publiclab/spectrometer3/parts/box/box_design/spec-box-top-alltab-yagiz.jpg

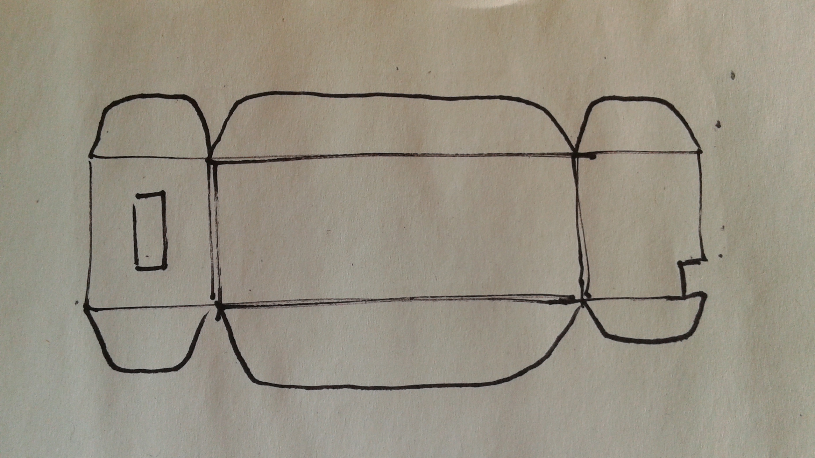
parts/box/box_design/spec-box-top-alltab-yagiz.jpg
