publiclab/spectrometer3/photos/IMG_3429.JPG

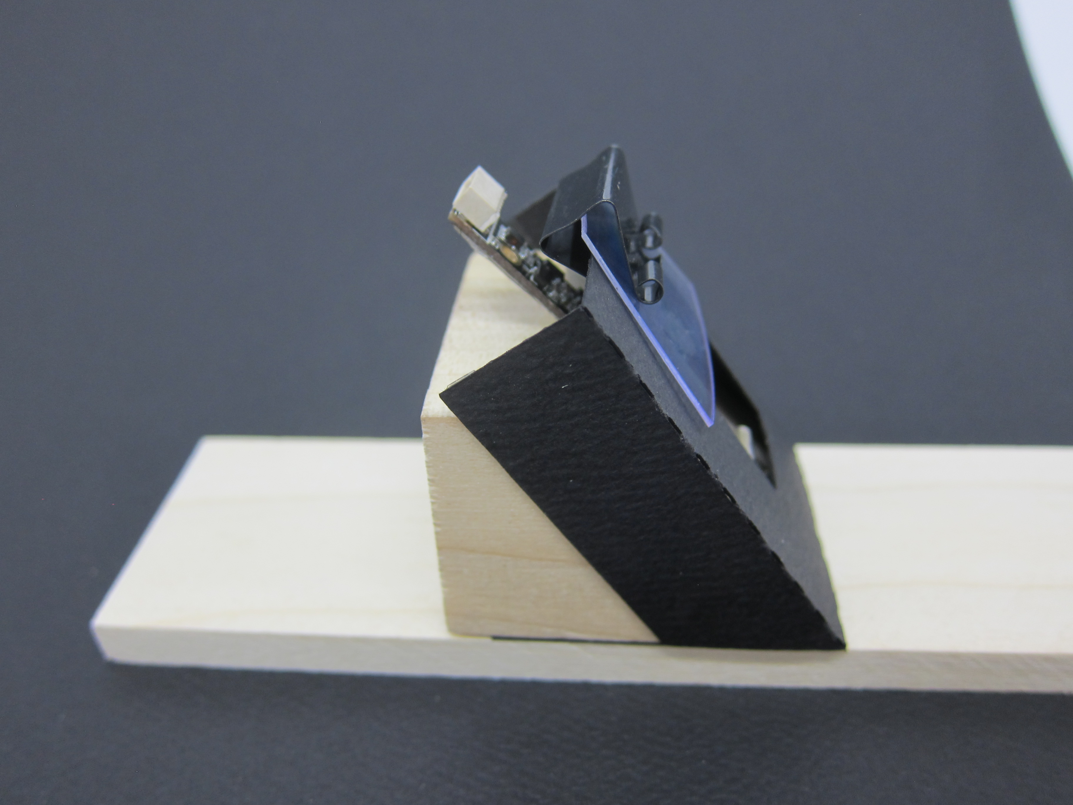
photos/IMG_3429.JPG
