publiclab/spectrometer3/photos/IMG_3420.JPG

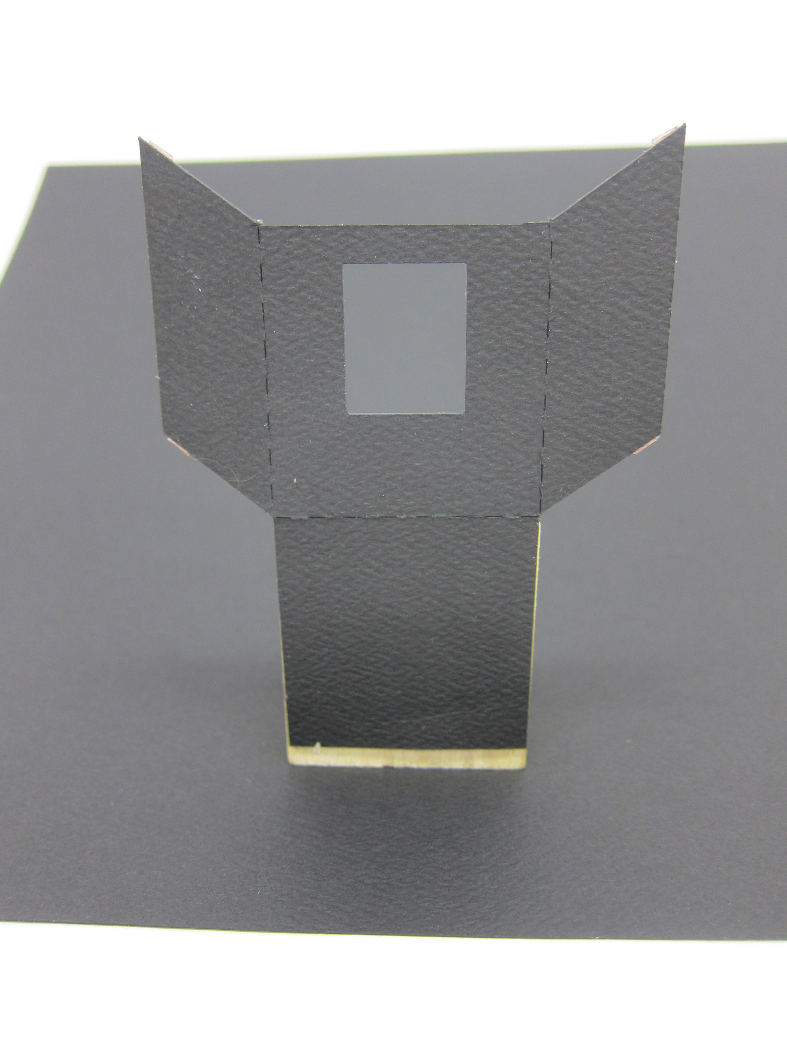
photos/IMG_3420.JPG
