publiclab/spectrometer3/photos/IMG_3421.JPG

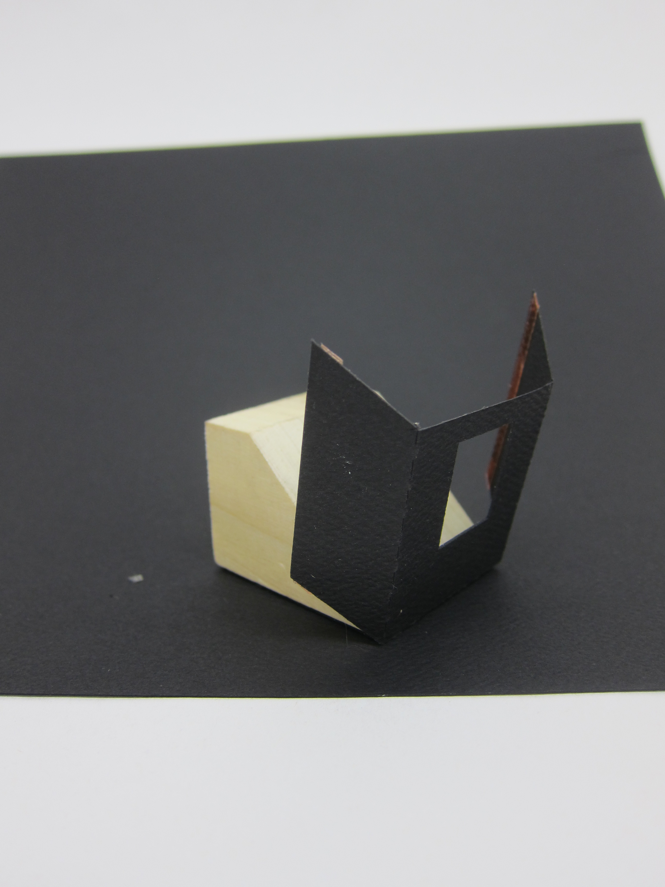
photos/IMG_3421.JPG
