publiclab/spectrometer3/photos/IMG_3422.JPG

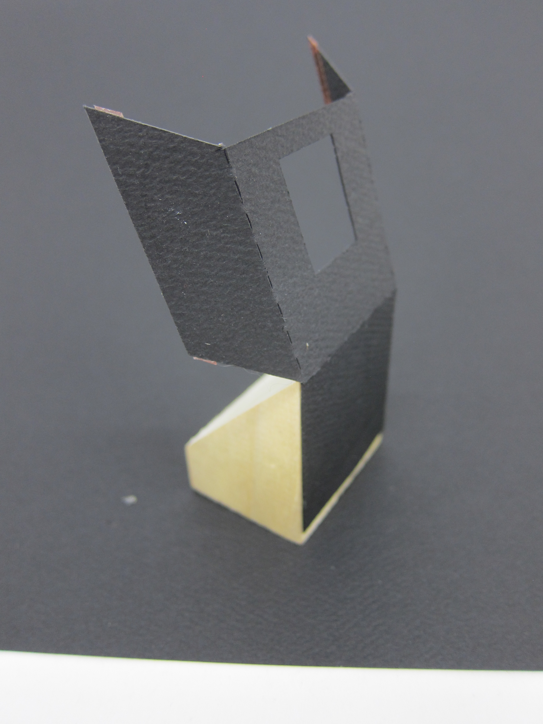
photos/IMG_3422.JPG
