publiclab/spectrometer3/photos/IMG_3423.JPG

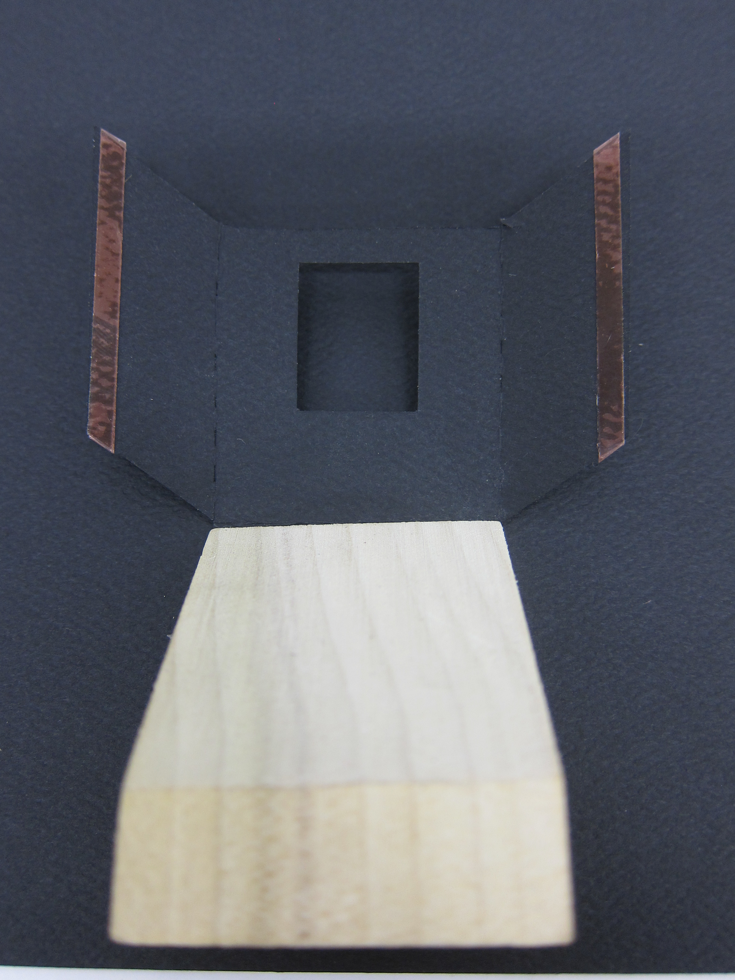
photos/IMG_3423.JPG
