publiclab/spectrometer3/photos/IMG_3424.JPG

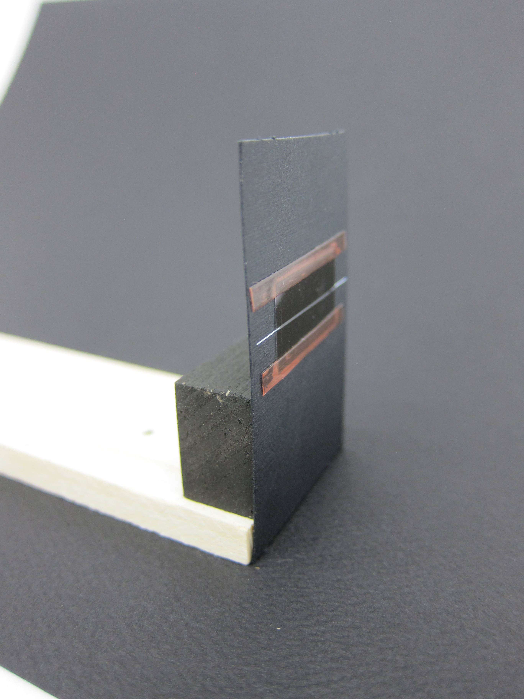
photos/IMG_3424.JPG
