publiclab/spectrometer3/photos/IMG_3426.JPG

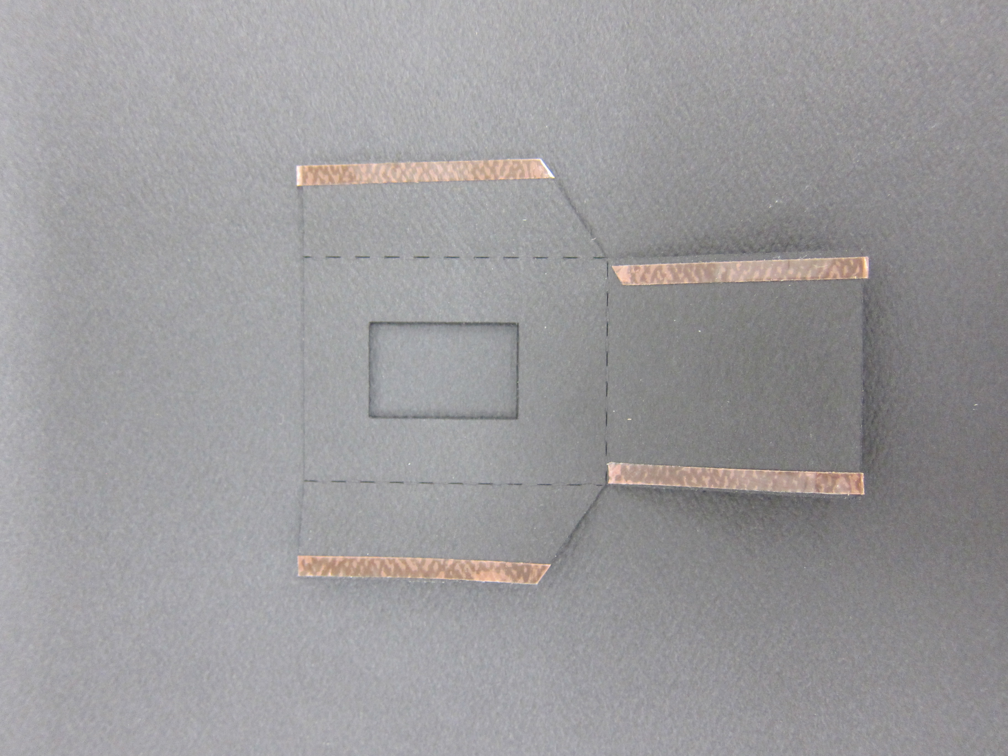
photos/IMG_3426.JPG
