publiclab/spectrometer3/photos/IMG_3427.JPG

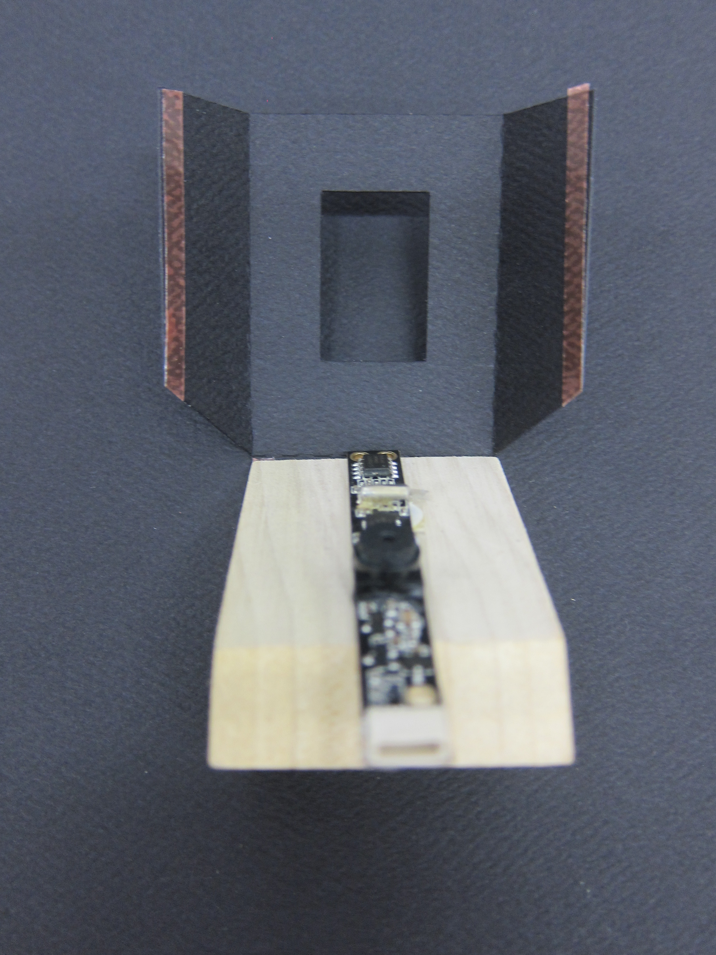
photos/IMG_3427.JPG
