publiclab/spectrometer3/photos/IMG_3428.JPG

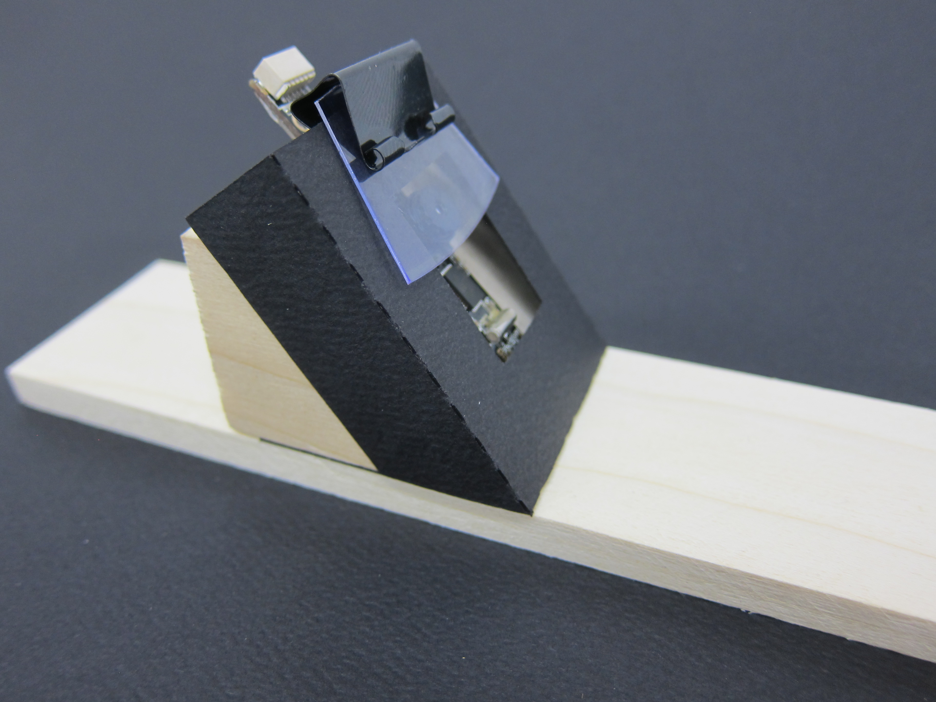
photos/IMG_3428.JPG
