publiclab/spectrometer3/photos/IMG_3430.JPG

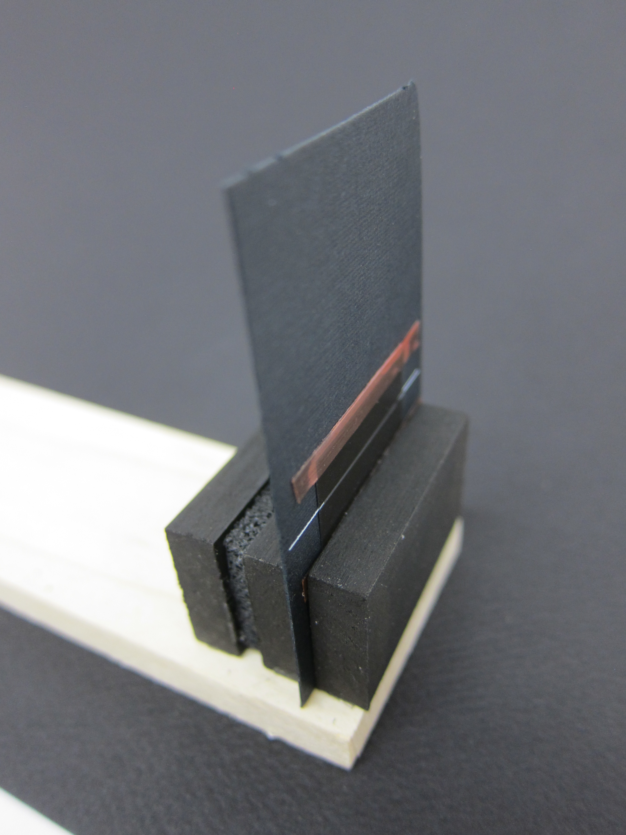
photos/IMG_3430.JPG
