publiclab/spectrometer3/photos/IMG_3431.JPG

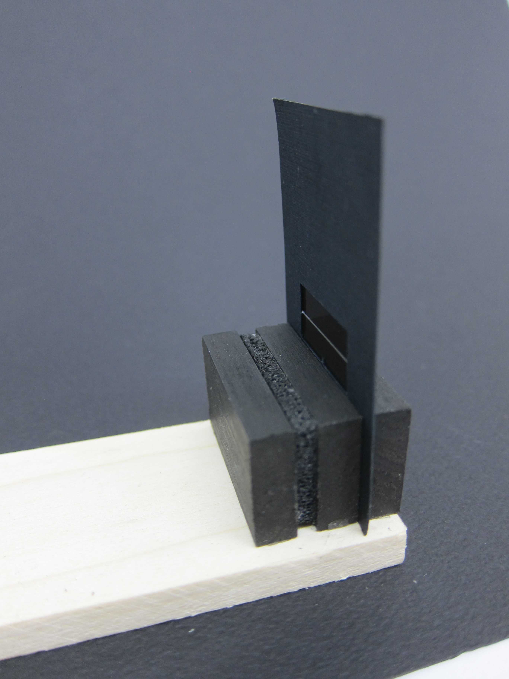
photos/IMG_3431.JPG
