publiclab/spectrometer3/photos/IMG_3432.JPG

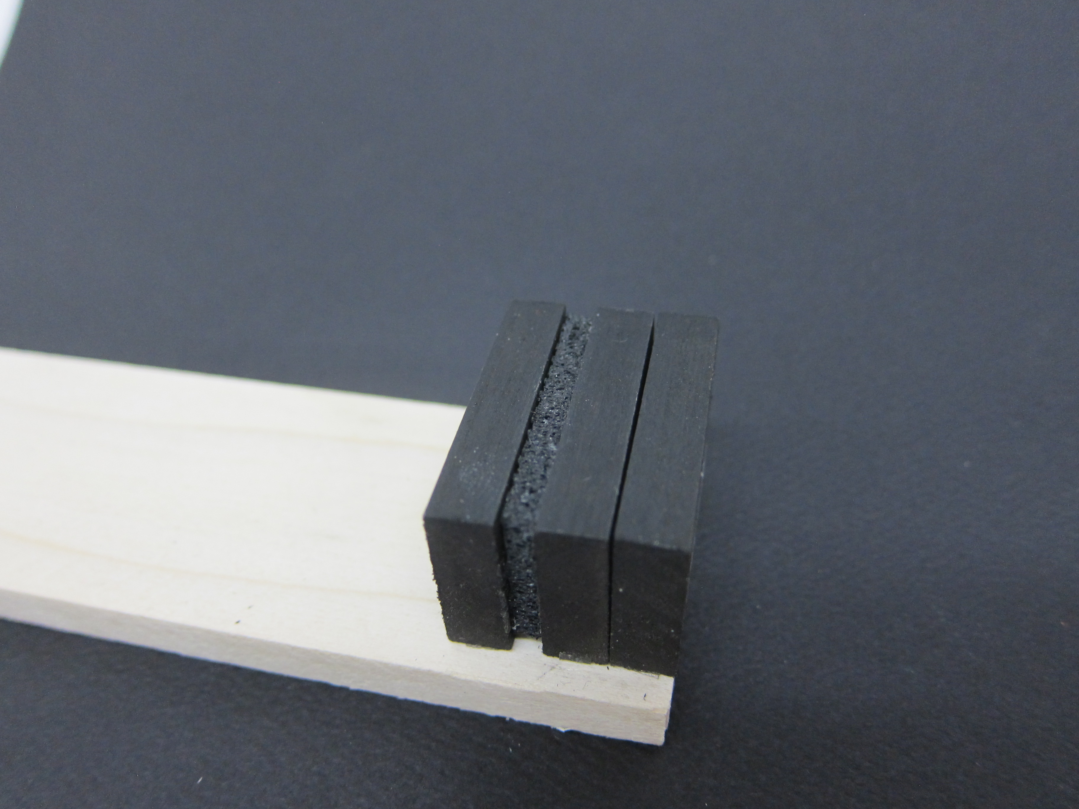
photos/IMG_3432.JPG
