publiclab/spectrometer3/photos/IMG_3433.JPG

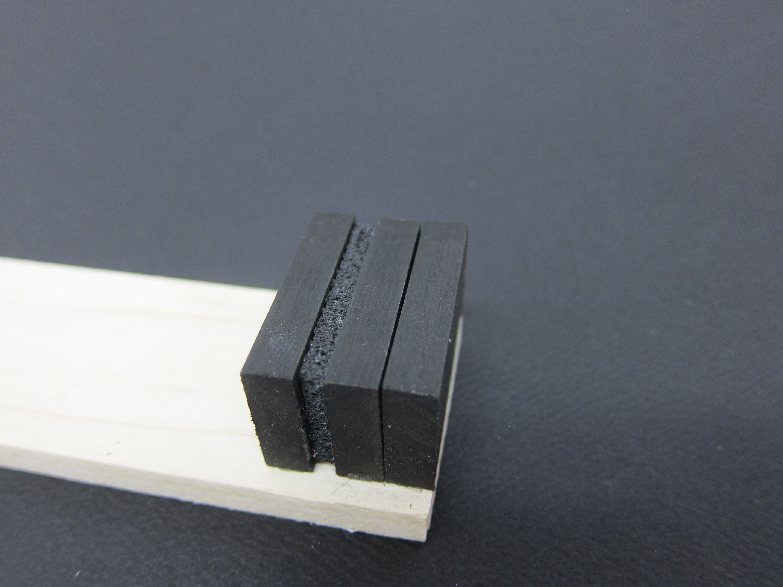
photos/IMG_3433.JPG
