publiclab/spectrometer3/photos/IMG_3434.JPG

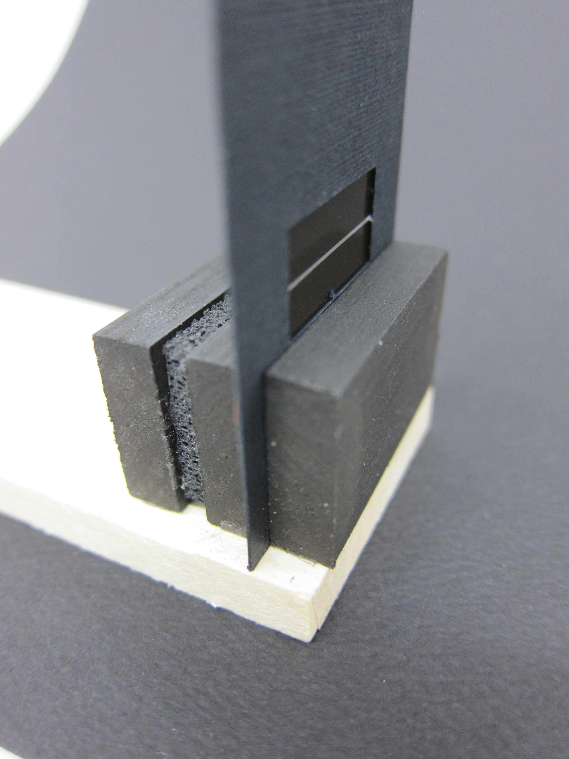
photos/IMG_3434.JPG
