publiclab/spectrometer3/photos/IMG_3435.JPG

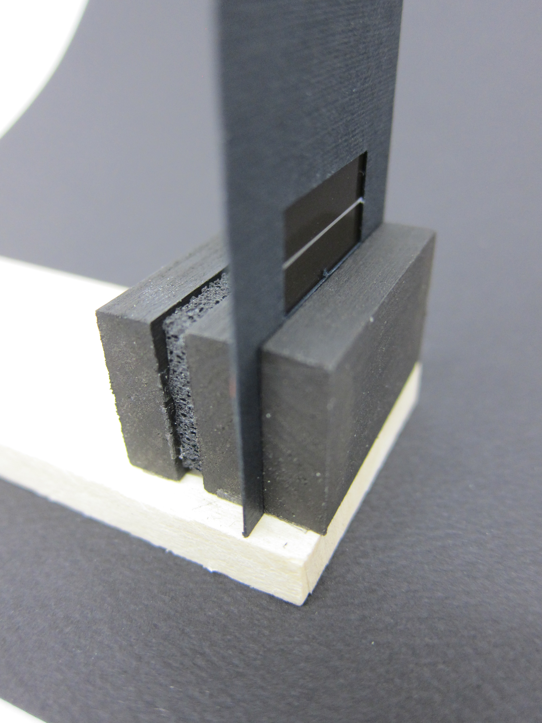
photos/IMG_3435.JPG
