publiclab/spectrometer3/photos/IMG_3436.JPG

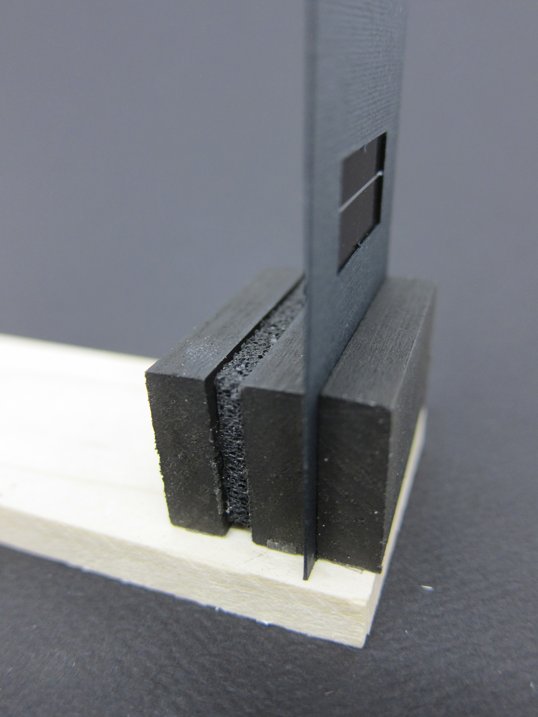
photos/IMG_3436.JPG
