publiclab/spectrometer3/photos/IMG_3437.JPG

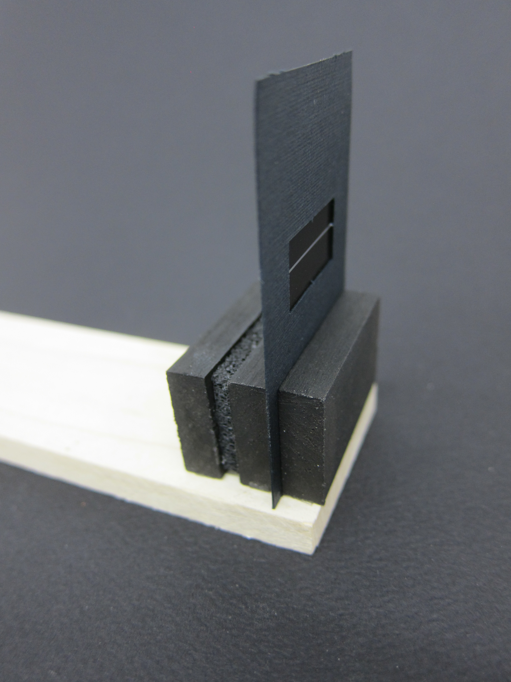
photos/IMG_3437.JPG
