publiclab/spectrometer3/photos/IMG_3438.JPG

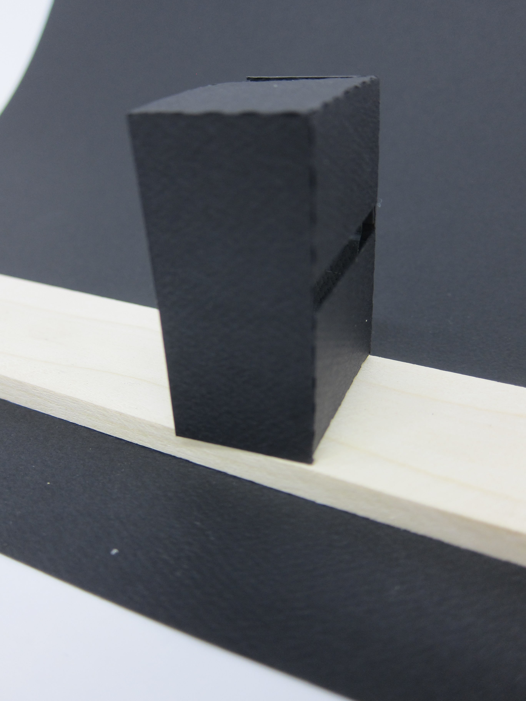
photos/IMG_3438.JPG
