publiclab/spectrometer3/photos/IMG_3439.JPG

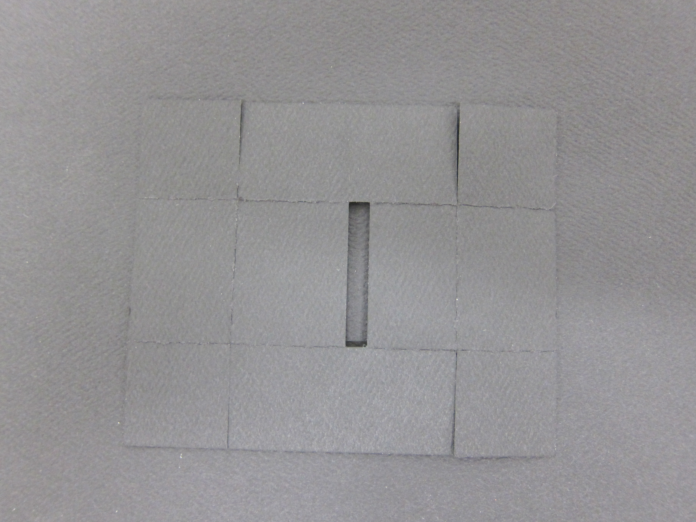
photos/IMG_3439.JPG
