publiclab/spectrometer3/parts/electronic_parts/camera_datasheet/camera-side-view.BMP

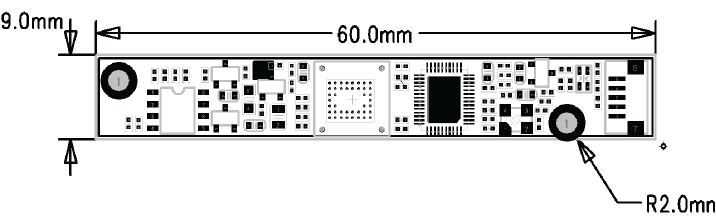
parts/electronic_parts/camera_datasheet/camera-side-view.BMP
