publiclab/spectrometer3/parts/electronic_parts/camera_datasheet/camera-top-view.BMP

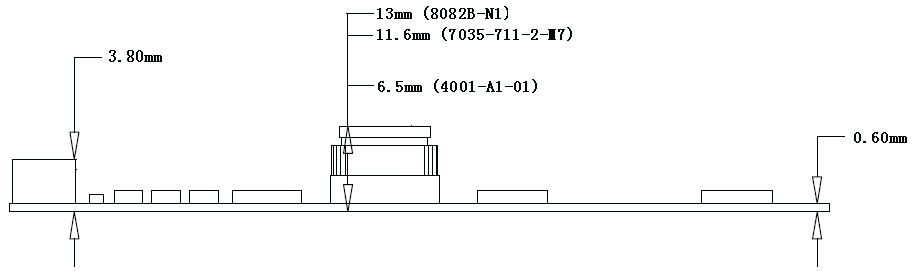
parts/electronic_parts/camera_datasheet/camera-top-view.BMP
