publiclab/spectrometer3/parts/paper-parts/baffle.bmp

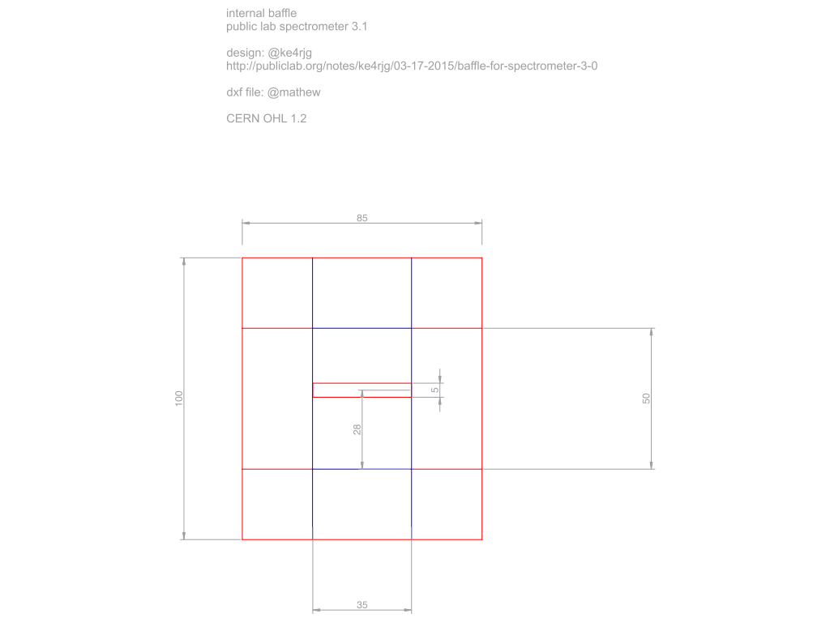
parts/paper-parts/baffle.bmp
