publiclab/spectrometer3/parts/paper-parts/grating-holder4.bmp

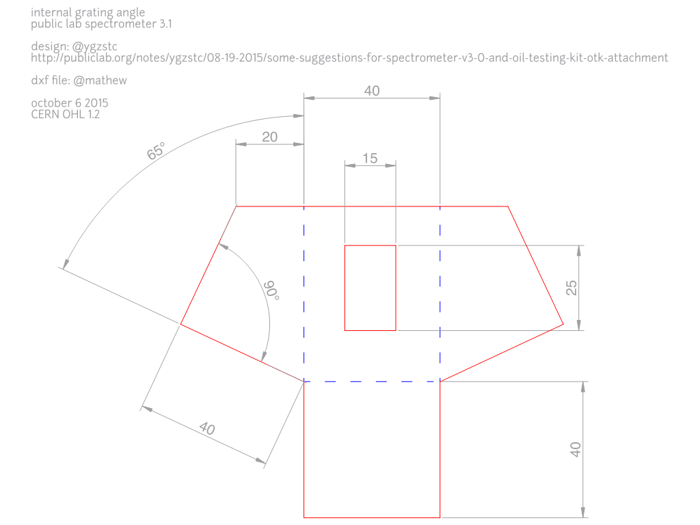
parts/paper-parts/grating-holder4.bmp
