publiclab/spectrometer3/parts/wood_parts/bench.bmp

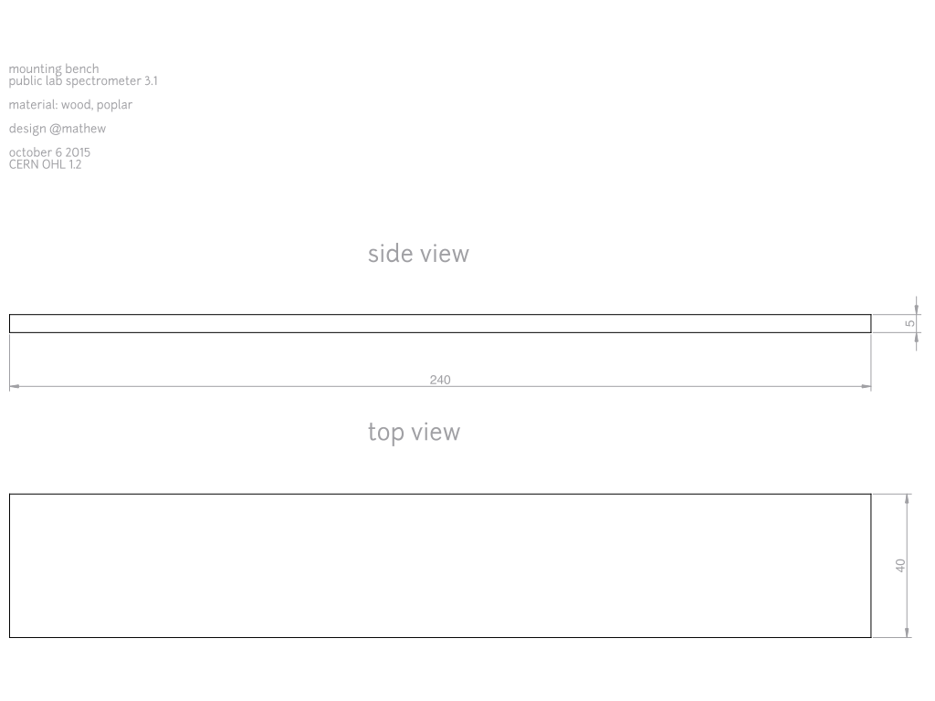
parts/wood_parts/bench.bmp
