publiclab/spectrometer3/parts/wood_parts/big-block.bmp

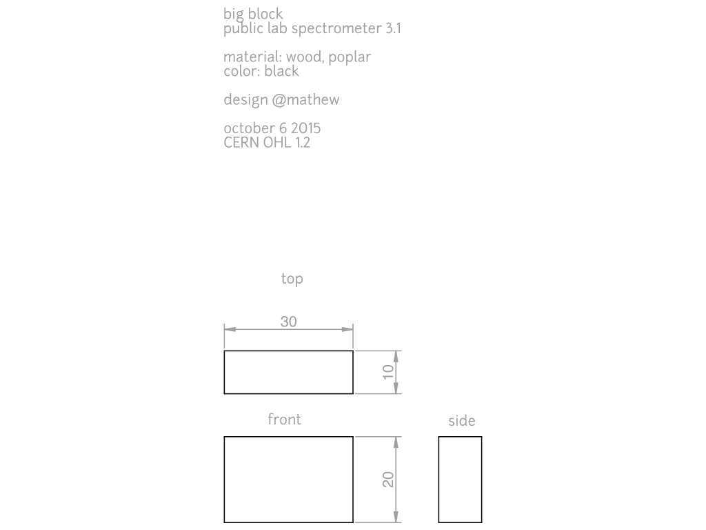
parts/wood_parts/big-block.bmp
