publiclab/spectrometer3/parts/wood_parts/camera-block.bmp

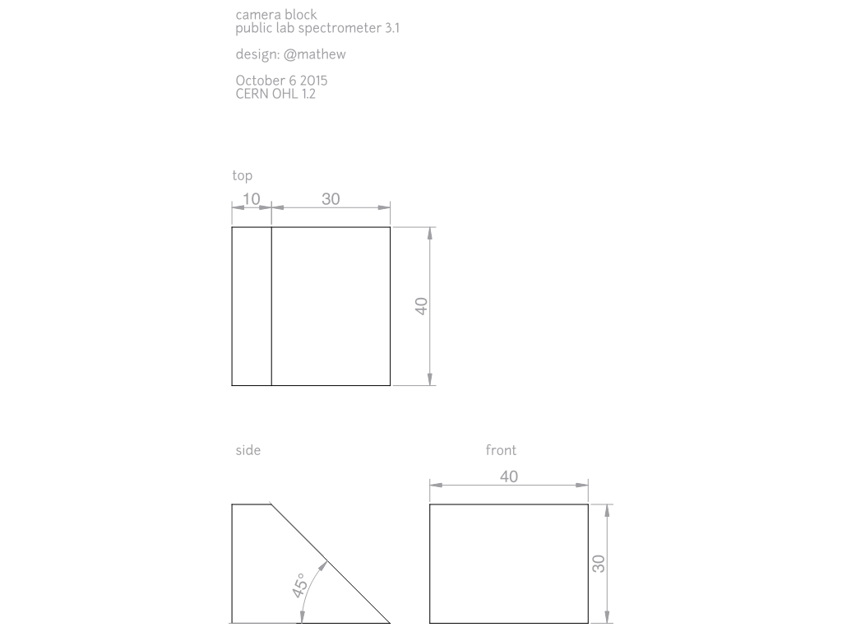
parts/wood_parts/camera-block.bmp
