publiclab/spectrometer3/layout1-stoft.dxf

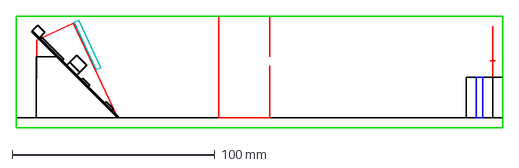
[picture p28: CAD file, 2015-10-08]
layout1-stoft.dxf
240.0 x 55.0 mm
