publiclab/spectrometer3/parts/electronic_parts/camera.dxf

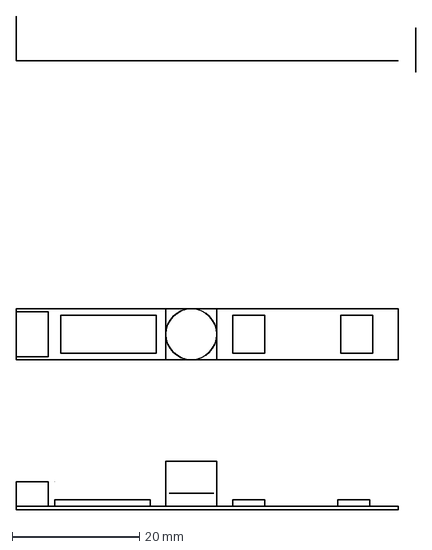
[picture p29: CAD file, 2015-10-08]
parts/electronic_parts/camera.dxf
62.7 x 77.6 mm
