publiclab/spectrometer3/parts/paper-parts/baffle.dxf

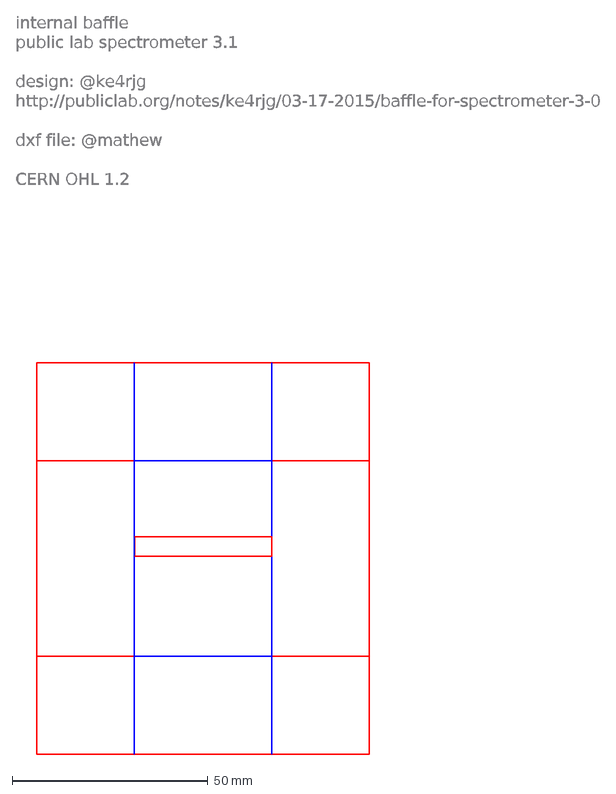
[picture p30: CAD file, 2015-10-08]
parts/paper-parts/baffle.dxf
internal baffle public lab spectrometer 3.1 design: @ke4rjg http://publiclab.org/notes/ke4rjg/03-17-2015/baffle-for-spectrometer-3-0 dxf file: @mathew CERN OHL
