publiclab/spectrometer3/layout3-mathew1.dxf

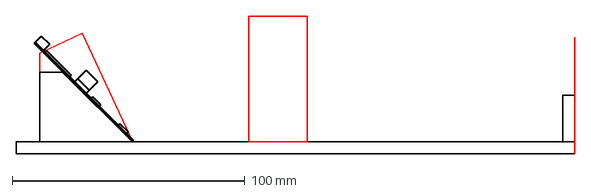
[picture p32: CAD file, 2015-10-08]
layout3-mathew1.dxf
240.0 x 59.0 mm
