publiclab/spectrometer3/parts/paper-parts/grating-holder4.dxf

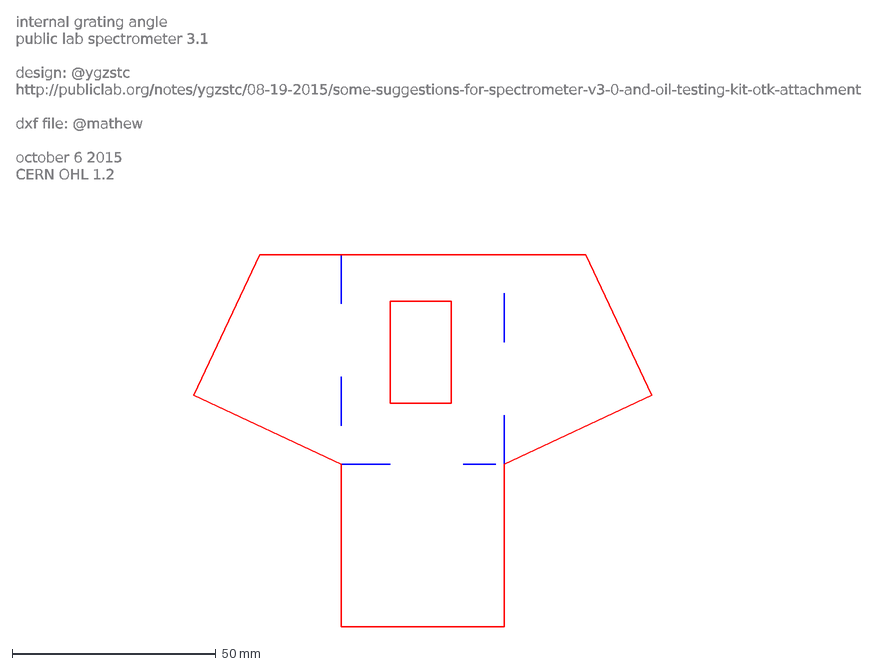
[picture p33: CAD file, 2015-10-08]
parts/paper-parts/grating-holder4.dxf
internal grating angle public lab spectrometer 3.1 design: @ygzstc http://publiclab.org/notes/ygzstc/08-19-2015/some-suggestions-for-spectrometer-v3-0-and-oil-t
