publiclab/spectrometer3/parts/wood_parts/camera-block.dxf

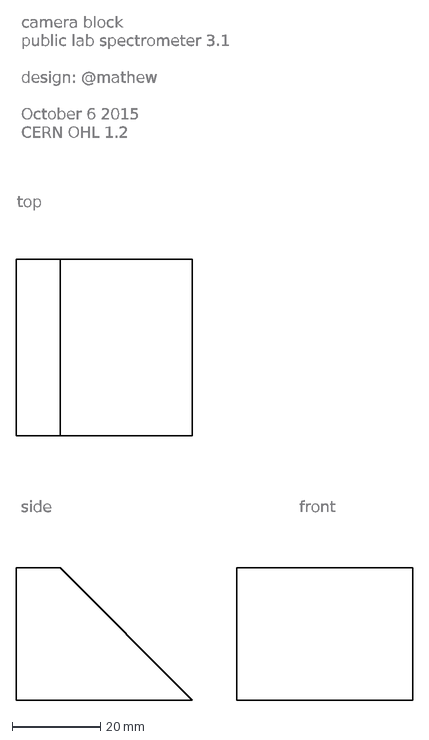
[picture p34: CAD file, 2015-10-08]
parts/wood_parts/camera-block.dxf
front
side
top
camera block public lab spectrometer 3.1 design: @mathew October 6 2015 CERN OHL 1.2
