publiclab/spectrometer3/layout2-mathew.dxf

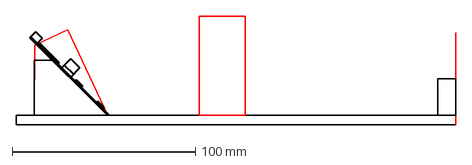
[picture p35: CAD file, 2015-10-08]
layout2-mathew.dxf
240.0 x 59.0 mm
