publiclab/spectrometer3/parts/wood_parts/block.dxf

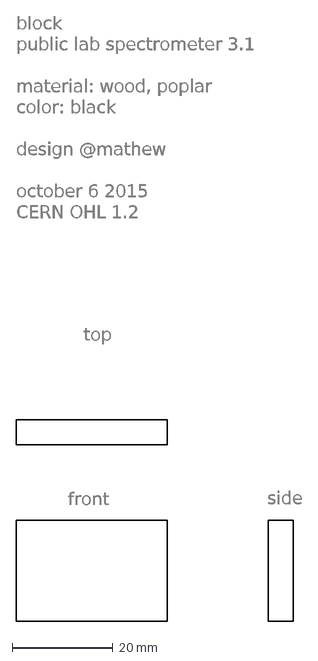
[picture p37: CAD file, 2015-10-08]
parts/wood_parts/block.dxf
block public lab spectrometer 3.1 material: wood, poplar color: black design @mathew october 6 2015 CERN OHL 1.2
top
front
side
