publiclab/spectrometer3/parts/wood_parts/bench.dxf

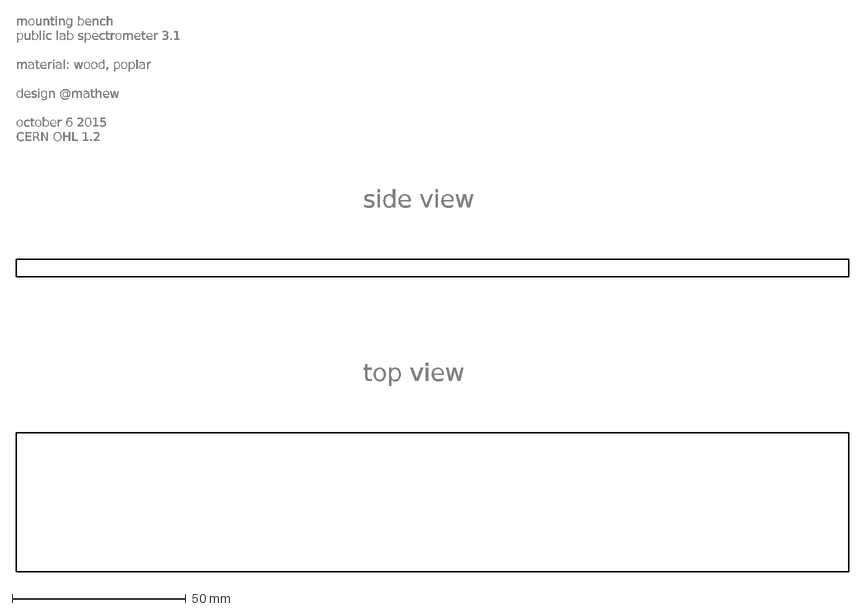
[picture p38: CAD file, 2015-10-08]
parts/wood_parts/bench.dxf
mounting bench public lab spectrometer 3.1 material: wood, poplar design @mathew october 6 2015 CERN OHL 1.2
side view
top view
