publiclab/spectrometer3/old/grating-holder.dxf

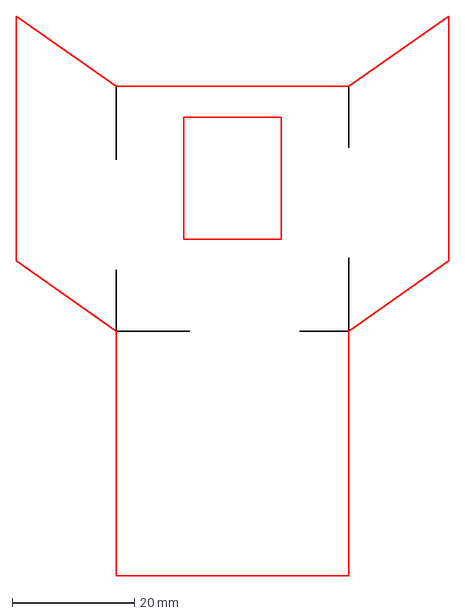
[picture p39: CAD file, 2015-10-08, an earlier design]
old/grating-holder.dxf
70.8 x 91.5 mm
