publiclab/spectrometer3/old/grating-holder2.dxf

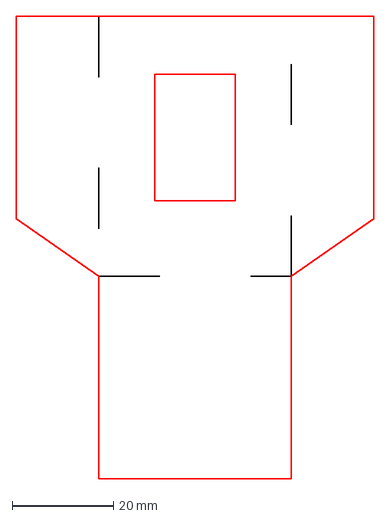
[picture p40: CAD file, 2015-10-08, an earlier design]
old/grating-holder2.dxf
70.8 x 91.5 mm
