publiclab/spectrometer3/(threads)

Thread 6 (2014-08-07):

label user contributions in the printed parts

mathewlippincott, 2014-08-07:
put a note that references the research note that led to a design feature, so users can learn more, such as: /n/12345
print these directly onto the kit.

mathewlippincott, 2015-01-20:
Done.
http://publiclab.org/notes/mathew/01-17-2015/shortlinks-putting-contributors-directly-on-a-kit

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

Closed 2015-01-20.

Thread 13 (2015-03-19):

shorten spec very slightly to fit in box

jywarren, 2015-03-19:
I had some clearance issues with the box tabs; even a 0.5cm shortening would help!

http://publiclab.org/notes/stevie/01-28-2015/working-with-the-spec-3-0#c11319

tonypubliclab, 2015-11-03:
if we made the side walls slightly lower, this piece would fit in the box at the current length. Right now it is slightly too long in both directions. If the walls were shorter, the piece would fit flat in the box. If the piece fit flat in the box, the issue with the length, where the box flaps interfere with the housing, becomes a non-issue. If this piece were sitting flat on the bottom, the box flaps would actually pin the piece down making it more secure for shipping.

I say if we can shorten the walls by a tiny amount, let's do that and leave the length as-is. This was feedback/idea from mathew, if any questions on how to implement...

mathewlippincott, 2015-11-03:
Here are the dimensional changes that would fit with the wood pieces I uploaded in the [community additions](https://github.com/publiclab/spectrometer3/tree/community-additions) branch
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

mathewlippincott, 2015-11-03:
here's the lid annotations:
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

jywarren, 2015-11-05:
Separating height from length size change - moving height (and @mathewlippincott's comments) to #31

Thread 18 (2015-07-27):

Add cover flap with tabs to OTK attachment

jywarren, 2015-07-27:
http://publiclab.org/notes/mathew/04-07-2015/assembling-the-oil-testing-kit-cuvette-frame

to reduce ambient light and laser scattering

jywarren, 2015-11-05:
Complete

Closed 2015-11-05.

Thread 20 (2015-08-03):

Longer/taller wood block

jywarren, 2015-08-03:
> I just assembled my Spectrometry kit 3.0. When I plugged in the USB, my computer did not recognize the device (webcam). I thought maybe I had not pushed the plug onto the camera enough so I pushed a little more, but alas it broke off.
> One good thing can come out of this and that is to revise the shape of the block. It needs to go higher to support the connection end of the camera so others don't do the same thing. There's plenty of room between the top of the box and the end of the webcam.

jywarren, 2015-08-03:
via Tim C

Thread 24 (2015-08-17):

Separation of internals from enclosure for rigidity

jywarren, 2015-08-17:
See @Stoft1's thoughts here: http://publiclab.org/notes/stoft/03-02-2015/plab-3-spectrometer-upgrade-prototype

The main point of separation we need to consider seems to be the slit -- i.e. is there a way to make a swappable slit as in the current design, but separate it from the casing? This doesn't even have to affect the current die cut designs, as it could be mounted on the plank inside, just a few millimeters back from the existing rectangular opening, with a cowling to prevent ambient light.

Thread 26 (2015-09-01):

labelled print layer scale indicator

jywarren, 2015-09-01:
that is at least as long as the greatest dimension in one axis, for confirming correct scale when going to cut or print

Thread 31 (2015-11-05):

Shorten box height to make fit in shipping box flat

jywarren, 2015-11-05:
The kit currently has to be diagonal to fit in the shipping box. Shorten it slightly (measurements coming) so it ships flat on the bottom.

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

jywarren, 2015-11-05:
Copying in solution via @mathewlippincott from #13 --

> Here are the dimensional changes that would fit with the wood pieces I uploaded in the [community additions](https://github.com/publiclab/spectrometer3/tree/community-additions) branch

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

> here's the lid annotations:

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

jywarren, 2015-11-09:
Just a note that this change must not cause trouble with the webcam clearance -- see this photo:

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

jywarren, 2015-11-09:
I'd like to drop it by 1cm (which would get us 2cm better fit in the box) but I'm not sure the webcam will allow for that. Will test it.

Thread 32 (2015-11-05):

Include slit print production file in repo

jywarren, 2015-11-05:
https://www.dropbox.com/work/plots/design/11-10-14-foldup-spectrometer-redesign

Thread 33 (2016-11-07):

Remove duplicated cut path

numeroteca, 2016-11-07:
I think there is a duplicated cut path in https://github.com/publiclab/spectrometer3/blob/master/spec-box-bottom.svg
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

jywarren, 2016-11-17:
Ah, could you submit a fixed file as a pull request? Thanks, Pablo!
