publiclab/spectrometer3/parts/paper-parts/baffle.pdf

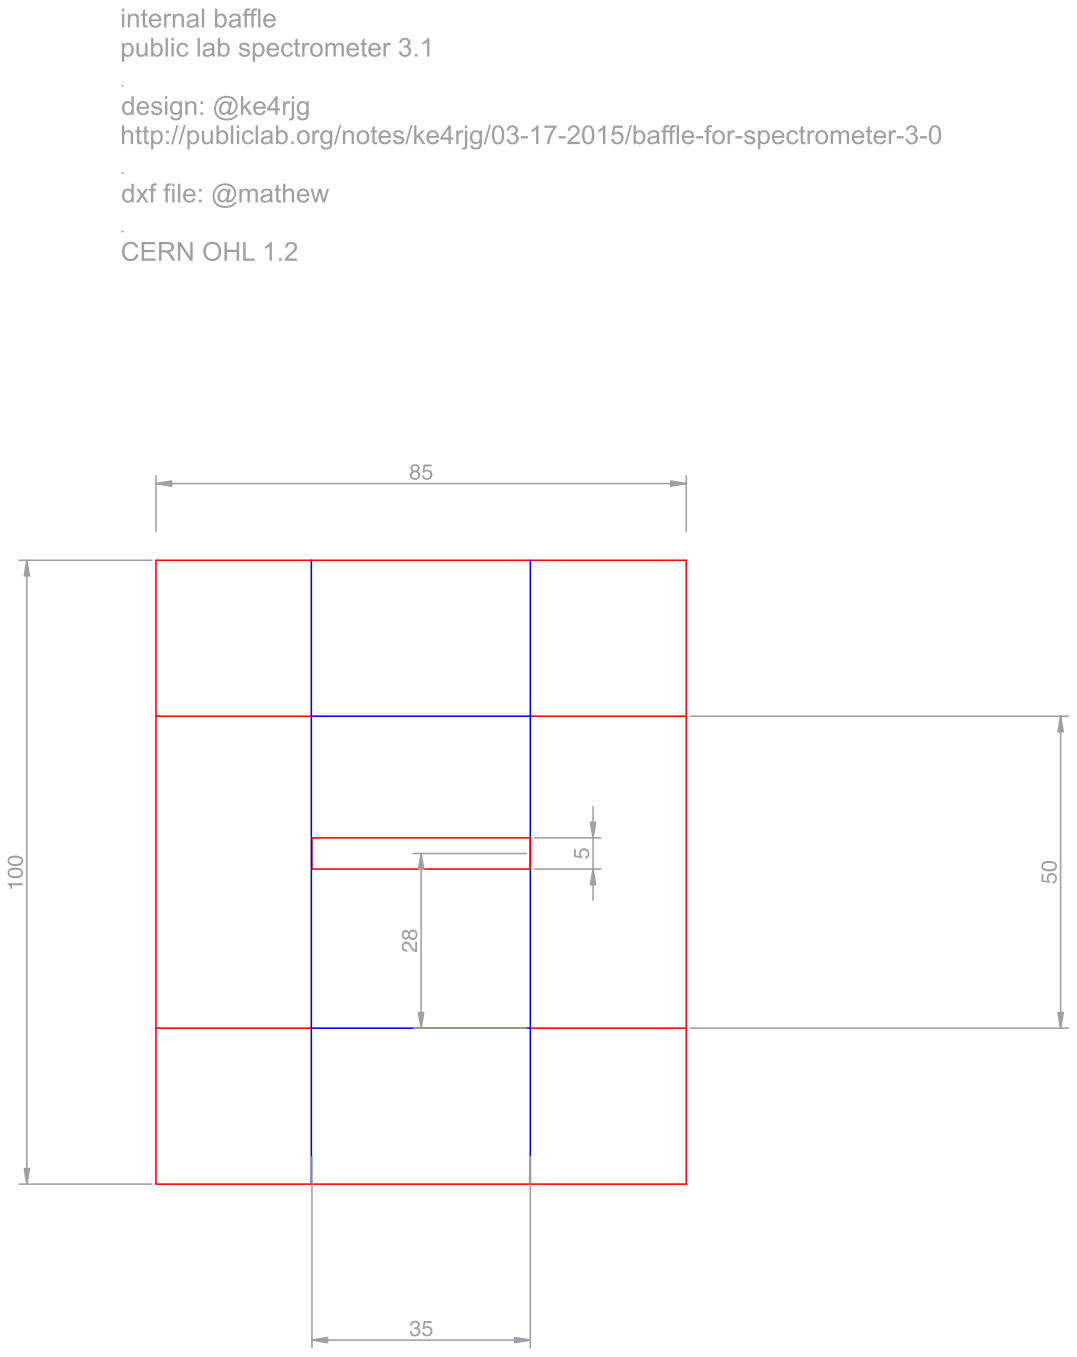
[picture p41: page 1]
