publiclab/spectrometer3/parts/paper-parts/grating-holder4.pdf

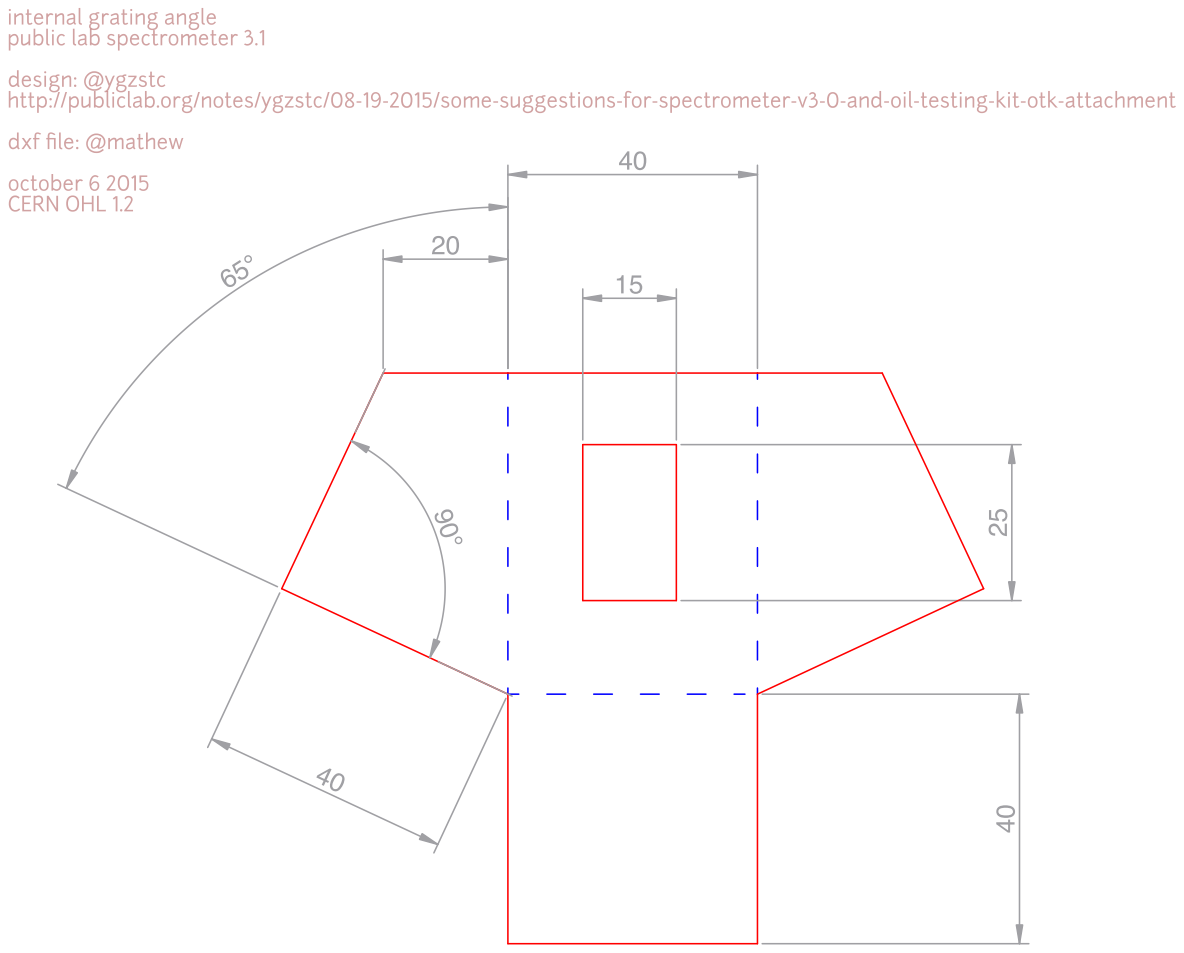
[picture p42: page 1]
