publiclab/spectrometer3/parts/wood_parts/big-block.pdf

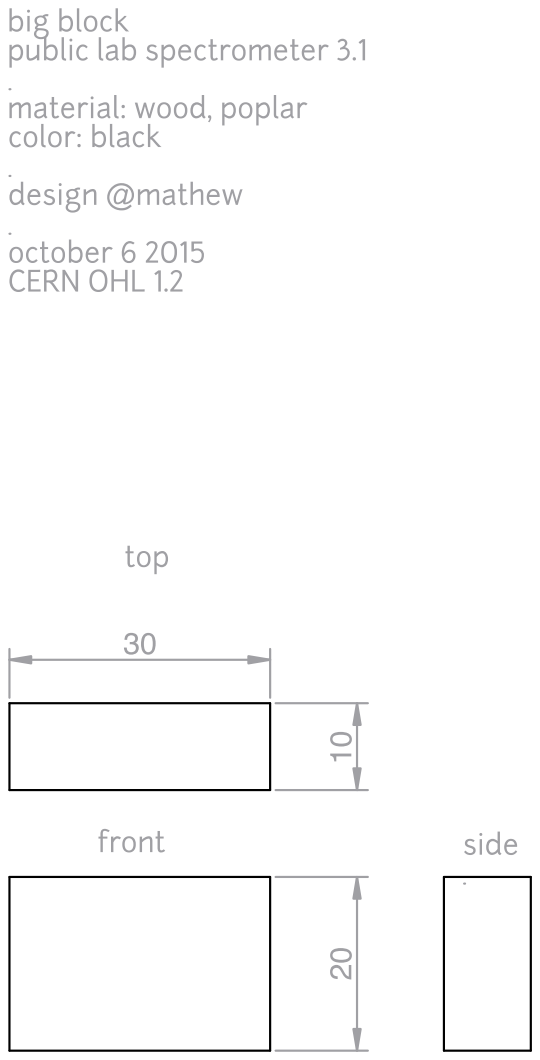
[picture p43: page 1]
