publiclab/spectrometer3/parts/wood_parts/camera-block.pdf

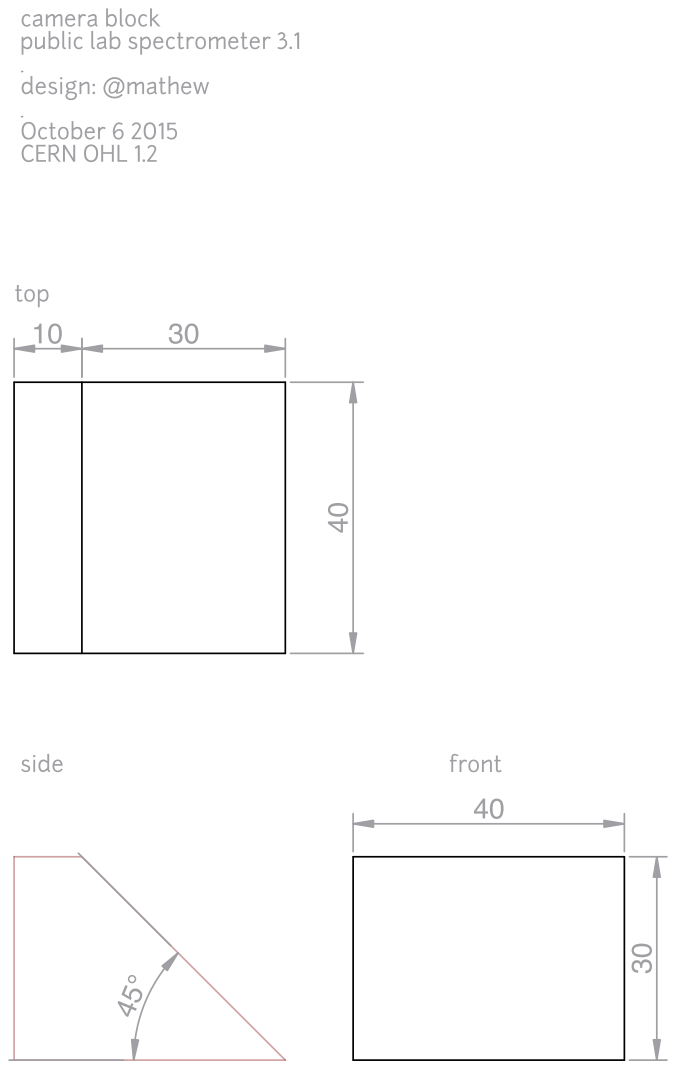
[picture p44: page 1]
