publiclab/spectrometer3/old/grating-holder3.pdf

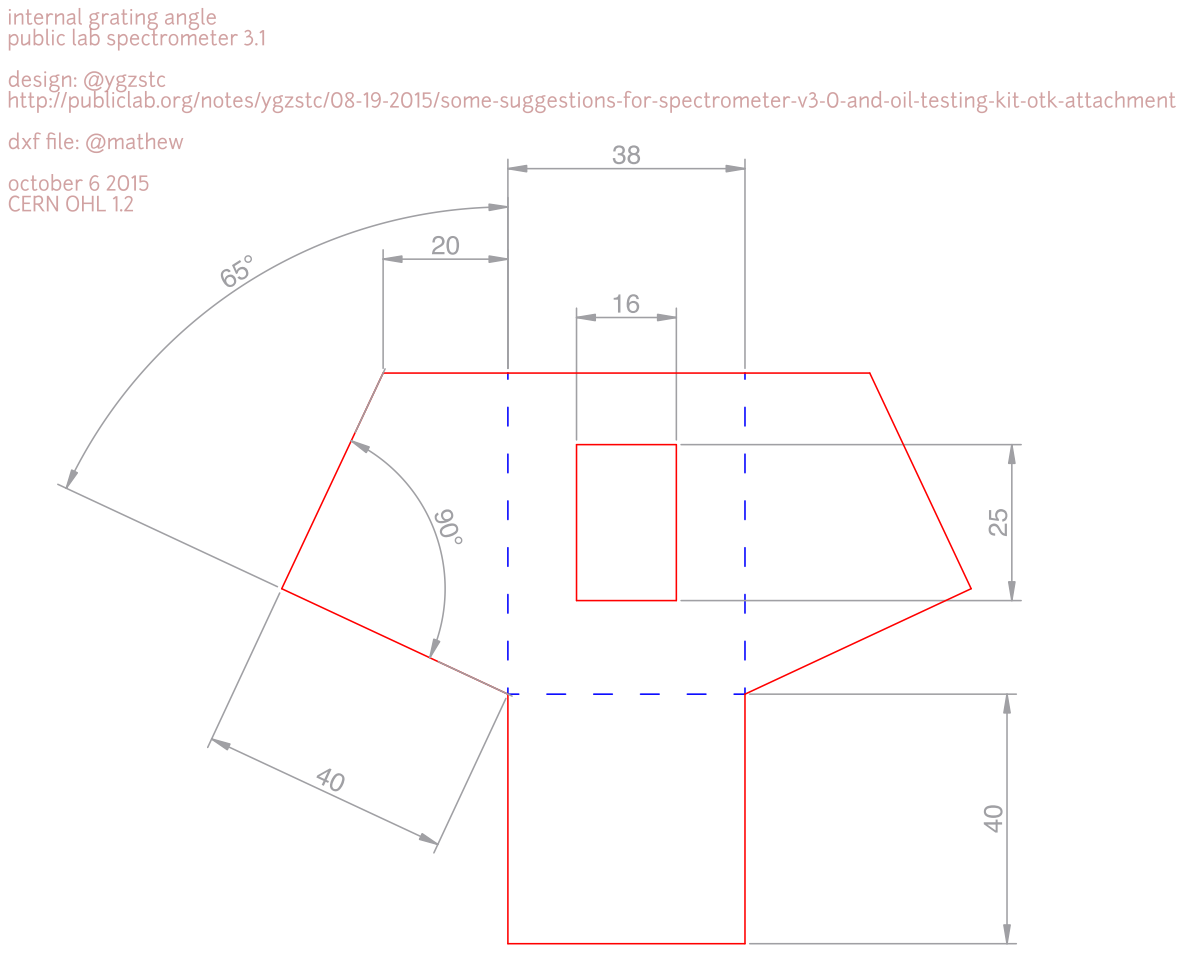
[picture p45: page 1]
