publiclab/spectrometer3/(commit log)

2015-08-15 adjusted lid tabs to not hit camera block
2015-10-08 round-up of additions from @stoft, @ygzstc, & @ke4rjg. All files are .dxf, with BMP files for web display and .pdf for print.
    The intention is to switch to using QCAD for part design
    https://github.com/qcad/qcad
    [baffle.bak000.dxf, baffle.dxf, bench.dxf, big-block.dxf, block.dxf, camera-block.dxf, camera.dxf, grating-holder copy.dxf]
