publiclab/spectrometer3/(notices)

Notices in the files:
old/grating-holder copy.dxf:
publiclab.org/notes/ygzstc/08-19-2015/some-suggestions-for-spectrometer-v3-0-and-oil-testing-kit-otk-attachment\P\Pdxf file: @mathew\P\Poctober 6 2015\PCERN OHL 1.2
parts/paper-parts/baffle.dxf:
publiclab.org/notes/ke4rjg/03-17-2015/baffle-for-spectrometer-3-0\P\Pdxf file: @mathew\P\PCERN OHL 1.2
